KaustubhKanagalekar/Cell-Stretching-Machine-/assets/Presentation and Report/Biomechanical Culture Reactor Poster 12.57.51.pptx.pdf

# Cellxercise Machine:

## Growing Synthetic Musculoskeletal Tissues

## Justin Dang, Kaustubh Kanagalekar, Jason Liu, Sheen Shaji, Alexander Haken

Department of Mechanical and Aerospace Engineering University of California San Diego

Overview
Dr. Peter Chen and Erik Dorthé from the Shiley Center for Orthopedic Research and Education Lab primarily oversee experiments and research pertaining to musculoskeletal tissue development such as tendons and meniscus tissues. Tendon and/or meniscus tissues that are artificially cultured, which is a big focus of the lab, need cyclic strain to promote growth and alignment of the cells. This is a machine that achieves just that!

What Is Needed?
- Provide ≥ 10% strain
- Run at 1 Hz cycles
- 20 N of force
- Sterilizable
- Easier nutrient feeding

Tensile
Clamp

Quick Release Fasteners

Removable Tray

Linear Rails and
Carriage

Load cell

SMAC Moving Coil
Actuator

Clamps

Quick Release
Fasteners

Removable Lift Plate

Locating pins

### Acknowledgements

Dr. Nathan Delson
Jackie Chen
Tom Chalfant
Stephen Mercsak
David Lesser
Mark Liu
Shellpa Pro | Our Machine
Tension Loading Only | Tension and Compression Loading
20 N Max Force | 41.5 N Max Continuous Force
Disposable Stretchy Silicone Tubs | Affordable Rigid Petri Dishes
Difficult Refeeding | Easy Access Refeeding
Clamps Restricted by Silicon Bed Design | Modular clamp Design

### Check Out the Comparison!

Impact on Society
This project enables researchers to explore novel techniques and breakthroughs in orthopedic repair, more specifically in the formation of tissues. Further applications of this research can result in new surgical procedures with faster recovery times

Area for Nutrient
Tray

### Future Improvements

- Potential auto-feeding
implementation
- Load measurement on
individual clamps

## Experiment Workflow

1. Insert fresh petri dish into tray holder
2. Detach lift plate from actuator
3. Fill petri dish with solution
4. Clamp cell strip, close lid
5. Move to incubator
6. Attach actuator to removable tray
7. Set actuator “zero”
8. Start strain cycle
9. Wait 3 days
10. Detach lift plate from actuator, and move to fume hood
11. Lift lid, and change solution
12. Move back to incubator
13. Re-attach gantry to actuator
14. Re-zero
15. Repeat
16. After experiment concludes, disassemble machine and autoclave clamps, sterilize everything else with ethanol wipes

Sponsored by Dr. Peter Chen and Erik Dorthe, Shiley Center for Orthopedic Research

Tension Load Testing

Measuring Friction

Load (N)

Time (s)

Load (N)

Time (s)
