KaustubhKanagalekar/Cell-Stretching-Machine-/(commit log)

2025-03-07 kaustubh jason alexander got strain control loop almost working, added interface, just have to fix velocity error where it is slower than intended
2025-05-02 trying to read arduino readings, unsure if works?
2025-05-12 adding load cell arduino code (sparkfun example)
2025-05-15 load cell readings code (w time sync issue)
    [LoadCellCalibrationInternetExample.ino]
2025-05-15 calibration coefficient to newton
